GROUP-4-ICT-360-IOT-FALL-2026-AUPP/weather-station-mini-project/models/weather_station.FCStd

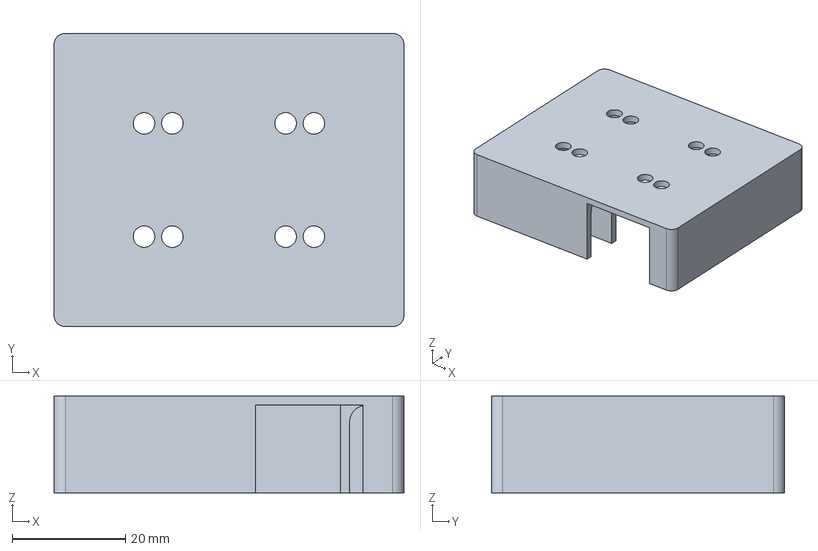
[picture p1: CAD file, 2026-11-10]
models/weather_station.FCStd
61.8 x 51.8 x 17.1 mm
