GROUP-4-ICT-360-IOT-FALL-2026-AUPP/weather-station-mini-project/schematic/version_001/version_001.pdf

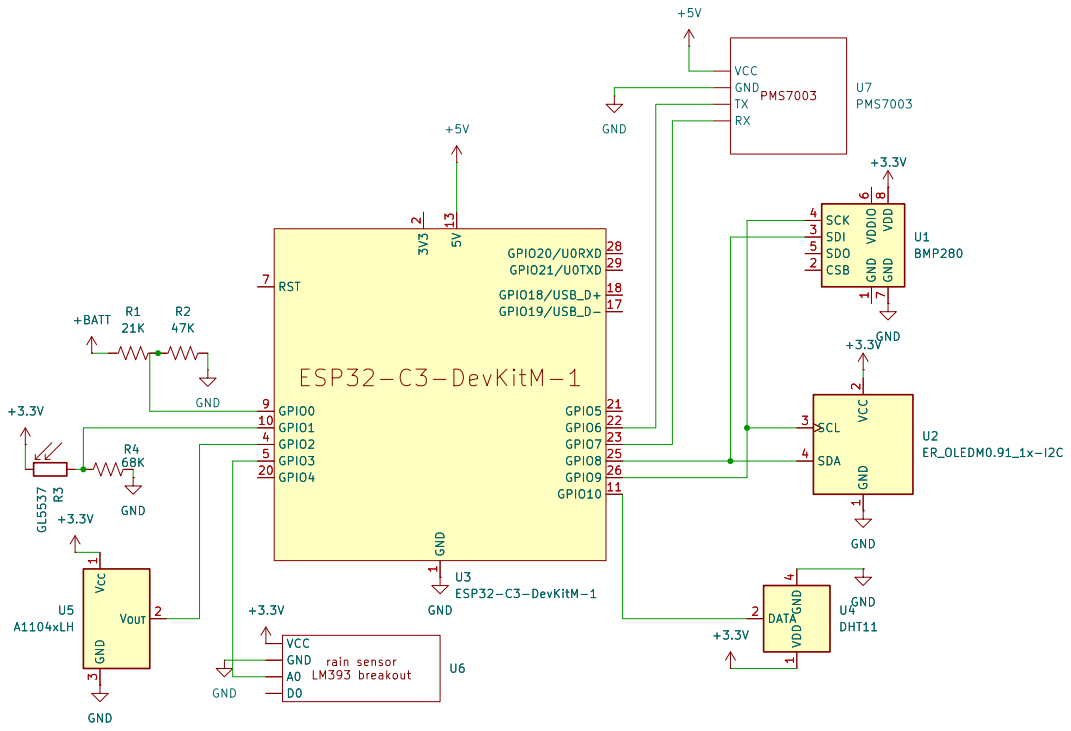
[picture p2: page 1]

rain sensor LM393 breakout VCC
GND

Sheet: /
File: version_001.kicad_sch
Title: local weather station

Size: A4 | Rev: version 1
KiCad E.D.A. 10.0.8 | Id: 1/1
