GROUP-4-ICT-360-IOT-FALL-2026-AUPP/weather-station-mini-project/schematic/schematic_version_001.kicad_sch

## KiCad design schematic/schematic_version_001.kicad_sch (2026-11-06)

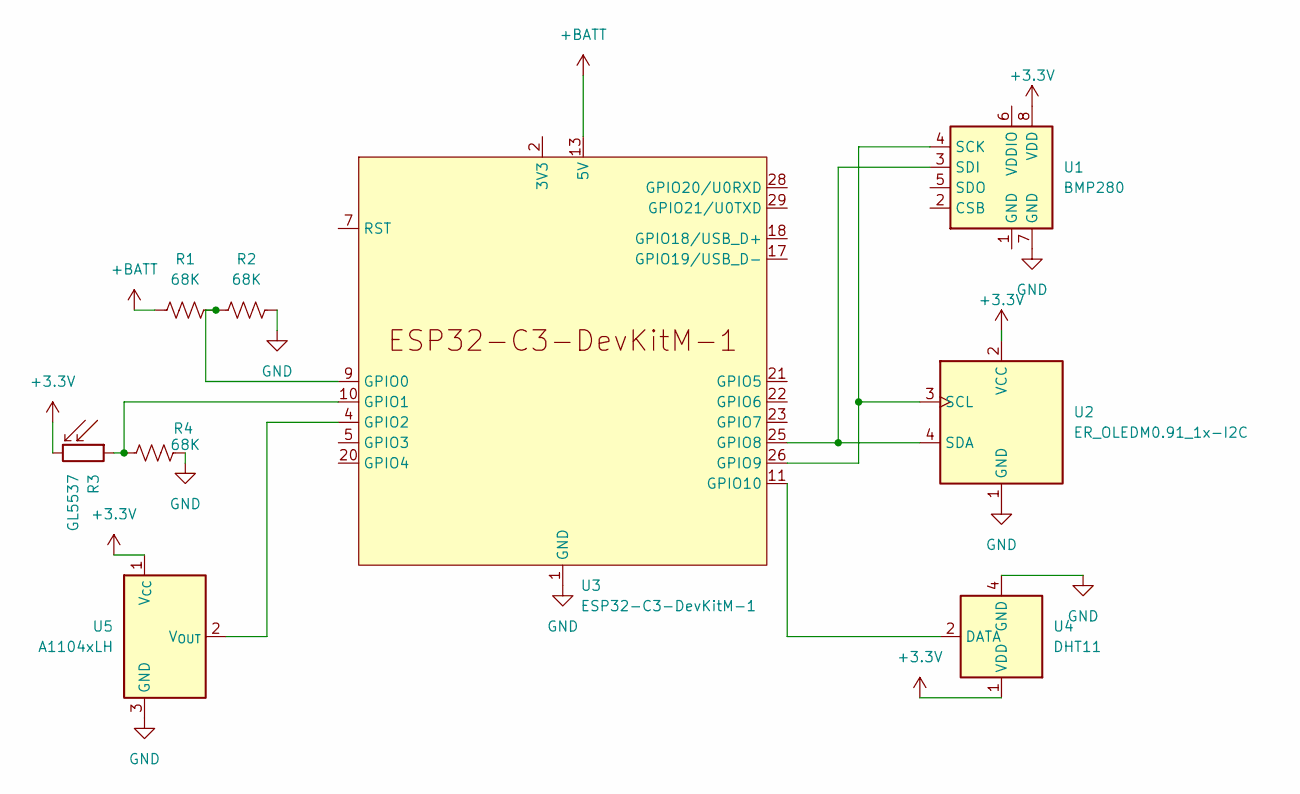
[picture p3: schematic schematic_version_001.kicad_sch]

Parts:
R1, R2, R4: 68K
R3: GL5537
U1: BMP280; Bosch_LGA-8_2x2.5mm_P0.65mm_ClockwisePinNumbering
U2: ER_OLEDM0.91_1x-I2C
U3: ESP32-C3-DevKitM-1
U4: DHT11; Aosong_DHT11_5.5x12.0_P2.54mm
U5: A1104xLH; SOT-23W

Connections:
+3.3V: R3.2, U1.8 (VDD), U2.2 (VCC), U4.1 (VDD), U5.1 (V_{CC})
+BATT: R1.2, U3.13 (5V), U3.14 (5V)
GND: R2.2, R4.1, U1.7 (GND), U2.1 (GND), U3.1 (GND), U3.6 (GND), U3.8 (GND), U3.12 (GND), U3.15 (GND), U3.16 (GND), U3.19 (GND), U3.24 (GND), U3.27 (GND), U3.30 (GND), U4.4 (GND), U5.3 (GND)
unnamed: R1.1, R2.1, U3.9 (GPIO0)
unnamed: R3.1, R4.2, U3.10 (GPIO1)
unnamed: U1.3 (SDI), U2.4 (SDA), U3.25 (GPIO8)
unnamed: U1.4 (SCK), U2.3 (SCL), U3.26 (GPIO9)
unnamed: U3.2 (3V3), U3.3 (3V3)
unnamed: U3.4 (GPIO2), U5.2 (V_{OUT})
unnamed: U3.11 (GPIO10), U4.2 (DATA)
