GROUP-4-ICT-360-IOT-FALL-2026-AUPP/weather-station-mini-project/src/weather_station/rain_sensor.py

import asyncio
from machine import ADC, Pin

FREQ = 1
PERIOD_MS = int(1000/FREQ)

PIN = 3

async def main(states):
    adc = ADC(Pin(PIN))
    while True:
        raw_value = adc.read_u16()
        states["rain_sensor"] = raw_value
        await asyncio.sleep_ms(PERIOD_MS)
