GROUP-4-ICT-360-IOT-FALL-2026-AUPP/weather-station-mini-project/(commit log)

2026-10-29 added some resistive sensors
2026-11-04 designed the base
    [schematic.kicad_sch, weather_station.FCStd]
2026-11-05 designed the cover
    [weather_station.FCStd]
2026-11-06 drew schematic
    [schematic.kicad_sch, schematic_version_001.kicad_sch, weather_station.FCStd]
2026-11-08 added the rest of the components
    [schematic.kicad_sch, version_001.kicad_sch, version_002.kicad_pcb, version_002.kicad_sch]
2026-11-08 wrote adc code
2026-11-09 connected dht11
    [version_002.kicad_pcb, version_002.kicad_sch]
2026-11-09 wired together most components other than oled and hall effect
2026-11-10 designed the pms7004 box for mounting
    [weather_station.FCStd]
2026-11-10 worked a bit on oled screen
    [weather_station.FCStd]
2026-11-11 added base station side code and also editted the esp32 side
2026-11-12 added a prototype of telegram bot
